kimkyowon/Hat_managing_system/Docs/개발 자료/FW 동작 로직.jpg

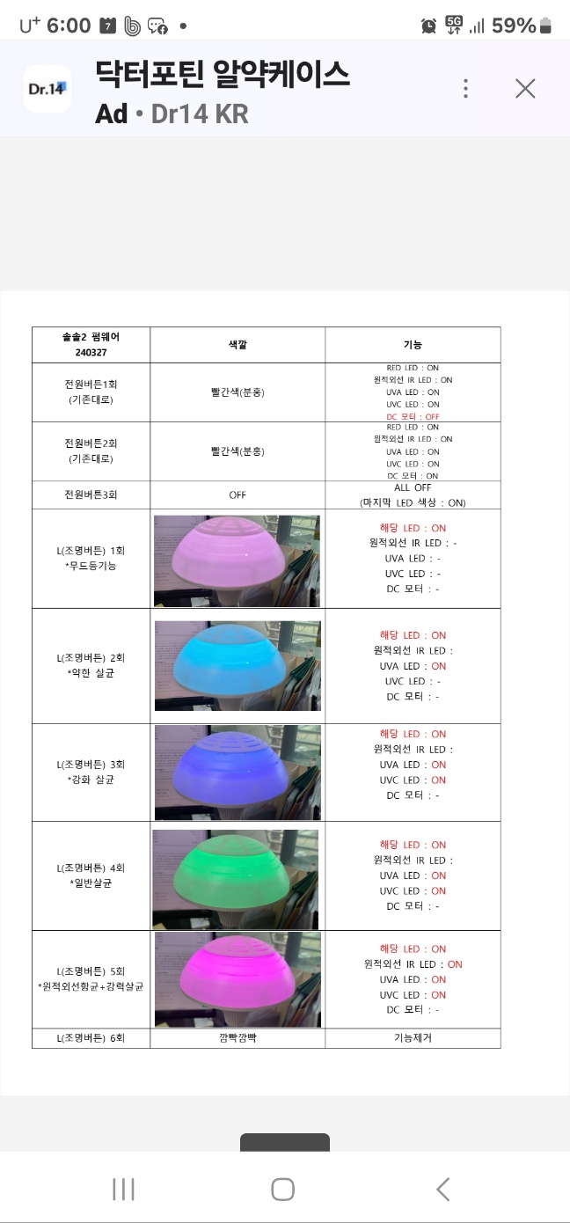
Docs/개발 자료/FW 동작 로직.jpg
