kimkyowon/Hat_managing_system/Docs/개발 자료/회로도 1차/1차회로.pdf

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
## NZR_WIGY_001_01

1 3.0
2024-05-21
C:\Users\thepr\Documents\git\others\NZR_WIGY_001\design\Power.SchDoc

Title

Number:
Date:
File:

Revision:
Sheet of

Author

Security

Doc Size A4 None Hyeonseok Shin

1
2
3
4
5
6
MP | 7

P1

12505WS-07

SW 1

SHDN 4

FB 3

IN 5

GND 2

U2

AP3015KTR-G1

FB1

MH1608-121Y

D1

SS14A

IN 1

EN 3

NC | 4
OUT | 5

GND 2

U1

TLV70233DBVR

L1

10uH

C5
4.7uF 10V

C4
10uF 6.3V

C2
0.1uF 50V

C1
0.1uF 50V

C3
0.1uF 50V

5V

SW2
SW1

5V

C6
1uF 16V

R2
499k 1%

R3
56k 1%

12V

5V

R1

10k 5%

3V3

USBLED

D D

C C

B B

A A

2 3

## NZR_WIGY_001_02

2 3.0

C:\Users\thepr\Documents\git\others\NZR_WIGY_001\design\MCU.SchDoc

Title

Number:

Revision:

Author

Security

Doc Size A4 None Hyeonseok Shin

PA0 7
PA1 8
PA2 9
PA3 10
PA4 11
PA5 12
PA6 13
PA7 14
PA11 16
PA12 17
PA13 18
PA15/PA14-BOOT0 19
PB0/PB1/PB2/PA8 | 15
PB3/PB4/PB5/PB6 | 20
PB7/PB8 | 1
PB9/PC14-OSC32_IN | 2
PC15-OSC32_OUT | 3

NRST 6

VDD/VDDA 4

VSS/VSSA 5

U3

STM32G030F6P6

1
2
3
4
5

P2

### 5 Pin Header

3V3

SWCLK
SWDIO
NRST

C7
0.1uF 50V

LEDD1012_G

UVLED_G

Q1
2N7002K-7

3V3

NRST

USBLED
SW2
SW1
EXTFAN_G

RGBR_G

SWDIO
SWCLK

BOOT 신경쓸것

LED12_G

R4

220R 5%
R6
22k 5%

Q2
R5 | 2N7002K-7

220R 5%
R7
22k 5%

Q3
R10 | 2N7002K-7

220R 5%
R12
22k 5%

Q4
R11 | 2N7002K-7

220R 5%
R13
22k 5%

Q7
R17 | 2N7002K-7

220R 5%
R19
22k 5%

Q8
R20 | 2N7002K-7

220R 5%
R21
22k 5%

Q6
R16 | 2N7002K-7

220R 5%
R18
22k 5%

RGBG_G

RGBB_G

1

### 2 MP

P3

12505WS-02

Q5
R14 | NDS355AN

220R 5%
R15
22k 5%

5V

R9
0.5R 5W

12V

HEATER_G

HEATER_G

EXTFAN_G

LEDD1012_G

RGBR_G

RGBG_G | LED12_G

RGBB_G

UVLED_G

RGB_R

RGB_G

RGB_B

UVLED

LED12

LEDD1012

R8
DNP

D D

C C

B B

A A

3 3

## NZR_WIGY_001_03

3 1.0

C:\Users\thepr\Documents\git\others\NZR_WIGY_001\design\Pheripherals.SchDoc

Title

Number:

Revision:

Author

Security
Doc Size | A4 *
D11 | XL-3528HIR-T202
D8 | CL-SFC281UV-395-B-02
D2 | CL-SFC3535UVC-270

D3
SFC506BRG-01
D12 | XL-3528HIR-T202
D15 | XL-3528HIR-T202
D5 | CL-SFC281UV-395-B-02

R22

121R 1%

R34

21R 1%

R43

68R 1%

R29

21R 1%

R46

68R 1%

R51

68R 1%

R27 | 294R 1%
R23 | 191R 1%
R25 | 191R 1%

5V

D6
SFC506BRG-01
R35 | 294R 1%
R30 | 191R 1%
R32 | 191R 1%

D9
SFC506BRG-01
R41 | 294R 1%
R37 | 191R 1%
R39 | 191R 1%

D4
SFC506BRG-01
R28 | 294R 1%
R24 | 191R 1%
R26 | 191R 1%

D7
SFC506BRG-01
R36 | 294R 1%
R31 | 191R 1%
R33 | 191R 1%

D10
SFC506BRG-01
R42 | 294R 1%
R38 | 191R 1%
R40 | 191R 1%

D13
SFC506BRG-01
R49 | 294R 1%
R44 | 191R 1%
R47 | 191R 1%

D16
SFC506BRG-01
R56 | 294R 1%
R52 | 191R 1%
R54 | 191R 1%

D18
SFC506BRG-01
R62 | 294R 1%
R58 | 191R 1%
R60 | 191R 1%

D14
SFC506BRG-01
R50 | 294R 1%
R45 | 191R 1%
R48 | 191R 1%

D17
SFC506BRG-01
R57 | 294R 1%
R53 | 191R 1%
R55 | 191R 1%

D19
SFC506BRG-01
R63 | 294R 1%
R59 | 191R 1%
R61 | 191R 1%

5V

RGB_R
RGB_G
RGB_B

5V

UVLED

LED12

LEDD1012
