kimkyowon/Hat_managing_system/Docs/개발 자료/회로도 1차/1차회로_usb.pdf

# NZR_WIGYUSB_001

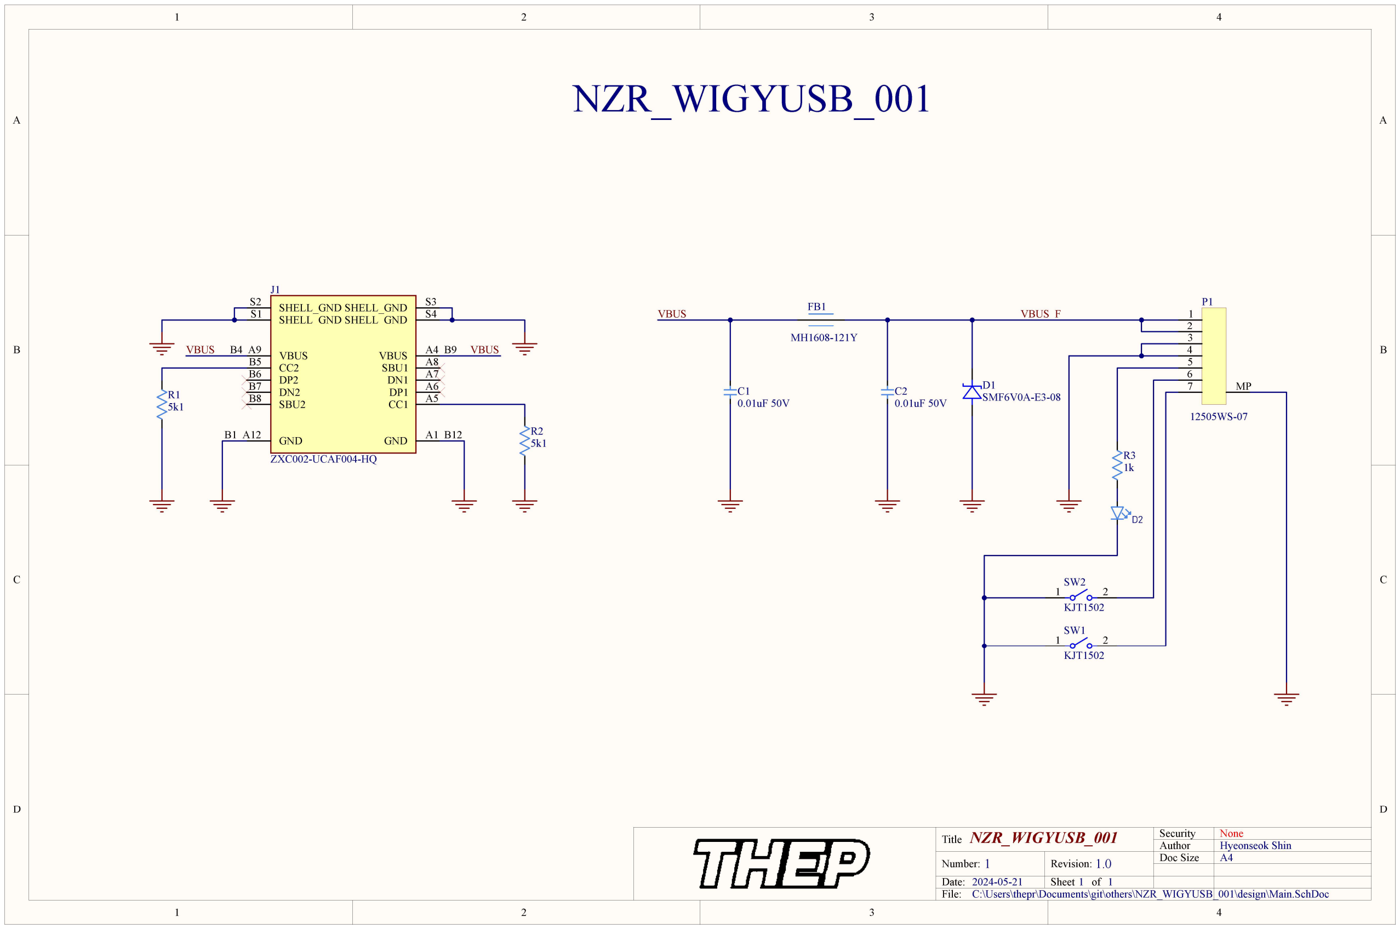
[picture p2: page 1]

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
## NZR_WIGYUSB_001

1 1.0
2024-05-21
C:\Users\thepr\Documents\git\others\NZR_WIGYUSB_001\design\Main.SchDoc

Title

Number:
Date:
File:

Revision:
Sheet of

Author

Security

Doc Size | A4 None Hyeonseok Shin
CC1 | A5 DP1 | A6 DN1 | A7 SBU1 | A8 VBUS | A4_B9 VBUS B4_A9
CC2 B5
DP2 B6
DN2 B7
SBU2 B8
GND | A1_B12 GND B1_A12
SHELL_GND S1 | SHELL_GND S2 | SHELL_GND | S3
| | SHELL_GND | S4

J1

ZXC002-UCAF004-HQ

D2

R2
5k1

D1
SMF6V0A-E3-08 C1
0.01uF 50V

1
2
3
4
5
6

### 7 MP

P1

12505WS-07

FB1

MH1608-121Y

R1
5k1
VBUS | VBUS

VBUS

C2
0.01uF 50V

VBUS_F

1 2

SW2

KJT1502

1 2

SW1

KJT1502

R3
1k
