kimkyowon/Hat_managing_system/Docs/개발 자료/Main_B SCH.png

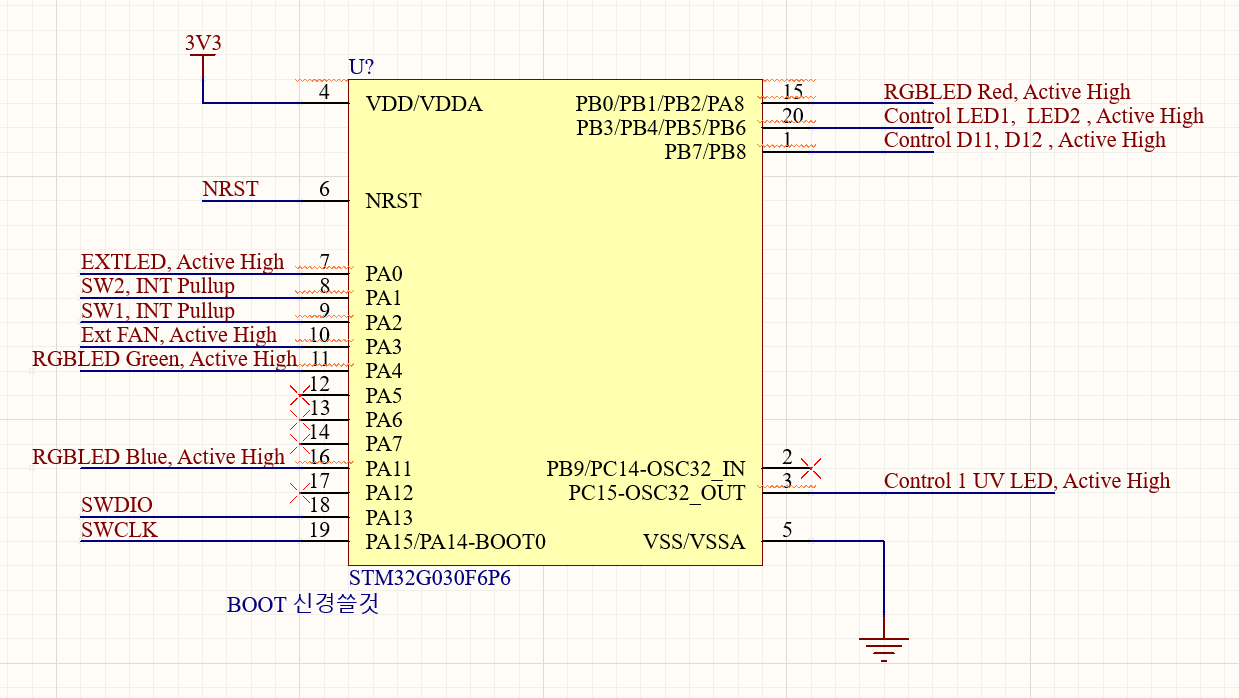
Docs/개발 자료/Main_B SCH.png
