kimkyowon/Hat_managing_system/Docs/견적서/자재_Bomlist/1차 제안서 기반 버전/김교원연구원(3KSET)견적서.xlsx

주식회사 플랜비넷
견 적 서
견적일자 : 2024년 04월 16일
 |  |  |  |  |  |  |  |  |  |  |  | 견적 번호 : P-240416-01
상 호 |  | . |  |  |  |  | 발 주 자 | 등록번호 | 202 - 81 - 66529
담당자 |  | 김교원연구원님 |  |  |  |  |  | 상 호 | 주식회사 플랜비넷 |  |  | 성 명 | 이 진희
Tel |  |  |  |  |  |  |  | 주 소 | 서울시 금천구 디지털로10길 78, 828호(가산테라타워)
Fax |  |  |  |  |  |  |  | 업 태 | 도매 |  |  | 종 목 | 전자부품, 무역
아래와 같이 견적합니다. |  |  |  |  |  |  |  | 전화번호 | 02-6230-5080 |  |  | 팩스 | 02-6230-5081
합 계 금 액 : |  |  | ₩18240530.00 |  |  |  |  | (VAT포함)
NO | Part Number |  |  |  | Maker |  |  | Q'ty | Price |  | Amuont |  |  | Delivery
1 | 12505WS-07 | 12505WS-07 | 12505WS-07 | 12505WS-07 | YEONHO | YEONHO | YEONHO | 3000 | ₩98.0 |  | ₩294000.00
2 | 12505WS-02 | 12505WS-02 | 12505WS-02 | 12505WS-02 | YEONHO | YEONHO | YEONHO | 3000 | ₩65.0 |  | ₩195000.00
3 | WCR 5ohm 5W | WCR 5ohm 5W | WCR 5ohm 5W | WCR 5ohm 5W | 바로전자 | 바로전자 | 바로전자 | 3000 | ₩150.0 |  | ₩450000.00
4 | 2N7002K-7 | 2N7002K-7 | 2N7002K-7 | 2N7002K-7 | DIODES | DIODES | DIODES | 21000 | ₩14.0 |  | ₩294000.00
5 | AP3015KTR-G1 | AP3015KTR-G1 | AP3015KTR-G1 | AP3015KTR-G1 | DIODES | DIODES | DIODES | 3000 | ₩230.0 |  | ₩690000.00
6 | MH1608-121Y | PZ1608U121-2R0TF | PZ1608U121-2R0TF | PZ1608U121-2R0TF | Bourns | SUNLOR | SUNLOR | 4000 | ₩33.0 |  | ₩132000.00 |  |  | 1REEL=4K
7 | NDS355AN | NDS355AN | NDS355AN | NDS355AN | ONSEMI | ONSEMI | ONSEMI | 3000 | ₩210.0 |  | ₩630000.00
8 | SS14A | SS14A | SS14A | SS14A | LSE | LSE | LSE | 5000 | ₩25.0 |  | ₩125000.00 |  |  | 1REEL=5K
9 | TLV70233DBVR | TLV70233DBVR | TLV70233DBVR | TLV70233DBVR | TI | TI | TI | 3000 | ₩65.0 |  | ₩195000.00
10 | EMC4012S-100M | EMC4012S-100M | EMC4012S-100M | EMC4012S-100M | EL3 | EL3 | EL3 | 4500 | ₩190.0 |  | ₩855000.00
11 | STM32G030F6P6 | STM32G030F6P6 | STM32G030F6P6 | STM32G030F6P6 | STM | STM | STM | 3000 | ₩425.0 |  | ₩1275000.00
12 | SFC506BRG-01 | S6-5050RGBTA TUOZHAN | S6-5050RGBTA TUOZHAN | S6-5050RGBTA TUOZHAN | CIELLIGHT | TUOZHAN | TUOZHAN | 27000 | ₩85.0 | ₩309.0 | ₩2295000.00 |  |  | S6-5050RGBTA 대치 핀맵 다름 확인 요청
13 | XL-3528HIR-T202 | XL-3528HIR-T202 | XL-3528HIR-T202 | XL-3528HIR-T202 | XINGLIGHT | TUOZHAN | TUOZHAN | 9000 | ₩90.0 | ₩666.0 | ₩810000.00 |  |  | XL-3528HIR-T202 대치 핀맵 동일
14 | SFC281UV-395-B-02(+) | NTD3528U2 | NTD3528U2 | NTD3528U2 | CIELLIGHT | TUOZHAN | TUOZHAN | 6000 | ₩80.0 | ₩495.0 | ₩480000.00 |  |  | NTD3528U2 핀맵 동일
15 | SFC3535UVC-270(15mW) | G3535N1UVN5U12-275NM | G3535N1UVN5U12-275NM | G3535N1UVN5U12-275NM | CIELLIGHT | TUOZHAN | TUOZHAN | 3000 | ₩1425 | ₩3212 | ₩4275000.00 |  |  | G3535N1UVN5U12-275nm 대치
16 | CRCW1210121RFKEA | CRCW1210121RFKEA | CRCW1210121RFKEA | CRCW1210121RFKEA | VISHAY | VISHAY | VISHAY | 5000 | ₩53.0 |  | ₩265000.00 |  |  | 1reel=5k
17 | WR12X21R0FTL | 21/1%/R3216 | 21/1%/R3216 | 21/1%/R3216 | Walsin | ANY | ANY | 10000 | ₩2.6 |  | ₩26000.00 |  |  | 1reel=5k
18 | WR12X68R0FTL | 68/1%/R3216 | 68/1%/R3216 | 68/1%/R3216 | Walsin | ANY | ANY | 10000 | ₩2.6 |  | ₩26000.00 |  |  | 1reel=5k
19 | WR06X1910FTL | 191/1%/R1608 | 191/1%/R1608 | 191/1%/R1608 | Walsin | ANY | ANY | 55000 | ₩0.9 |  | ₩49500.00 |  |  | 1reel=5k
20 | WR06X2940FTL | 294/1%/R1608 | 294/1%/R1608 | 294/1%/R1608 | Walsin | ANY | ANY | 30000 | ₩0.9 |  | ₩27000.00 |  |  | 1reel=5k
21 | WR04X4993FTL | 499K/1%/R1005 | 499K/1%/R1005 | 499K/1%/R1005 | Walsin | ANY | ANY | 10000 | ₩0.65 |  | ₩6500.00 |  |  | 1reel=10k
22 | WR04X5602FTL | 56k/1%/R1005 | 56k/1%/R1005 | 56k/1%/R1005 | Walsin | ANY | ANY | 10000 | ₩0.65 |  | ₩6500.00 |  |  | 1reel=10k
23 | WR04X103 JTL | 10K/5%/R1005 | 10K/5%/R1005 | 10K/5%/R1005 | Walsin | ANY | ANY | 20000 | ₩0.55 |  | ₩11000.00 |  |  | 1reel=10k
24 | WR04X221 JTL | 220 220/5%/R1005 | 220 220/5%/R1005 | 220 220/5%/R1005 | Walsin | ANY | ANY | 30000 | ₩0.55 |  | ₩16500.00 |  |  | 1reel=10k
25 | WR04X223 JTL | 22k/5%/R1005 | 22k/5%/R1005 | 22k/5%/R1005 | Walsin | ANY | ANY | 30000 | ₩0.55 |  | ₩16500.00 |  |  | 1reel=10k
26 | CL05B105KB5NNNC | 100n/50V/C1005 | 100n/50V/C1005 | 100n/50V/C1005 | samsung | ANY | ANY | 20000 | ₩3.8 |  | ₩76000.00 |  |  | 1REEL=10K
27 | CL10A105KO8NNNC | 1uF/16V/C1608 | 1uF/16V/C1608 | 1uF/16V/C1608 | samsung | ANY | ANY | 4000 | ₩3.0 |  | ₩12000.00 |  |  | 1REEL=4K
28 | CL10A475KP8NNNC | 4.7uF/10V/C1608 | 4.7uF/10V/C1608 | 4.7uF/10V/C1608 | samsung | ANY | ANY | 4000 | ₩3.8 |  | ₩15200.00 |  |  | 1REEL=4K
29 | CL10A106KP8NNNC | 10uF/10V/C1608 | 10uF/10V/C1608 | 10uF/10V/C1608 | samsung | ANY | ANY | 4000 | ₩4.9 |  | ₩19600.00 |  |  | 1REEL=4K
 |  |  |  |  |  |  |  |  |  |  | ₩0.00
30 | ZXC002-UCAF004-HQ | ZXC002-UCAF004-HQ | ZXC002-UCAF004-HQ | ZXC002-UCAF004-HQ |  |  |  | 3000 | ₩500.0 |  | ₩1500000.00 |  |  | 1일
31 | MH1608-121Y | PZ1608U121-2R0TF | PZ1608U121-2R0TF | PZ1608U121-2R0TF | Bourns | SUNLOR | SUNLOR | 4000 | ₩33.0 |  | ₩132000.00 |  |  | 1REEL=4K
32 | KJT 1502 250g | KJT 1502 250g | KJT 1502 250g | KJT 1502 250g | KJT | KJT | KJT | 6000 | ₩85 |  | ₩510000.00 |  |  | 1일
33 | NCD0603B1 | NTD3528U2 | NTD3528U2 | NTD3528U2 | NationStar | TUOZHAN | TUOZHAN | 4000 | ₩13.0 | ₩495.0 | ₩52000.00 |  |  | NTD3528U2 핀맵 동일
34 | 12505WR-07 | 12505WR-07 | 12505WR-07 | 12505WR-07 | YEONHO | YEONHO | YEONHO | 3000 | ₩150.0 |  | ₩450000.00
35 | SMF6V0A-E3-08 | SMF6V0A-E3-08 | SMF6V0A-E3-08 | SMF6V0A-E3-08 | Vishay | Vishay | Vishay | 3000 | ₩107.0 |  | ₩321000.00
36 | CL05B105KB5NNNC | 100n/50V/C1005 | 100n/50V/C1005 | 100n/50V/C1005 | ANY | ANY | ANY | 10000 | ₩3.8 |  | ₩38000.00 |  |  | 1REEL=10K
37 | WR04X102 JTL | 1K/5%/R1005 | 1K/5%/R1005 | 1K/5%/R1005 | ANY | ANY | ANY | 10000 | ₩0.55 |  | ₩5500.00 |  |  | 1REEL=10K
38 | WR04X512 JTL | 5.1K/5%/R1005 | 5.1K/5%/R1005 | 5.1K/5%/R1005 | ANY | ANY | ANY | 10000 | ₩0.55 |  | ₩5500.00 |  |  | 1REEL=10K
39 |  |  |  |  |  |  |  |  |  |  | ₩0.00
40 |  |  |  |  |  |  |  |  |  |  | ₩0.00
 |  |  |  |  |  |  |  |  |  |  | ₩0.00
합 계 |  |  |  |  |  |  |  |  |  |  | ₩16582300
납기일자 |  |  |  |  |  |  |  | 납품장소
유효일자 |  |  |  |  |  |  |  | 결제조건
비 고 |  | 담당자 : 이승진과장 010-6359-0223
