kimkyowon/Hat_managing_system/Docs/견적서/자재_Bomlist/1차 제안서 기반 버전/김교원연구원(SAMPLE)견적서-0416.xlsx

주식회사 플랜비넷
견 적 서
견적일자 : 2024년 04월 16일
 |  |  |  |  |  |  |  |  |  |  |  | 견적 번호 : P-240416-01
상 호 |  | . |  |  |  |  | 발 주 자 | 등록번호 | 202 - 81 - 66529
담당자 |  | 김교원연구원님 |  |  |  |  |  | 상 호 | 주식회사 플랜비넷 |  |  | 성 명 | 이 진희
Tel |  |  |  |  |  |  |  | 주 소 | 서울시 금천구 디지털로10길 78, 828호(가산테라타워)
Fax |  |  |  |  |  |  |  | 업 태 | 도매 |  |  | 종 목 | 전자부품, 무역
아래와 같이 견적합니다. |  |  |  |  |  |  |  | 전화번호 | 02-6230-5080 |  |  | 팩스 | 02-6230-5081
합 계 금 액 : |  |  | ₩53306.00 |  |  |  |  | (VAT포함)
NO | Part Number |  |  |  | Maker |  |  | Q'ty | Price |  | Amuont |  |  | Delivery
1 | 12505WS-07 | 12505WS-07 | 12505WS-07 | 12505WS-07 | YEONHO | YEONHO | YEONHO | 1 | ₩0.0 | ₩0.0 | ₩0.00 |  |  | SAMPLE
2 | 12505WS-02 | 12505WS-02 | 12505WS-02 | 12505WS-02 | YEONHO | YEONHO | YEONHO | 1 | ₩0.0 | ₩0.0 | ₩0.00 |  |  | SAMPLE
3 | WCR 5ohm 5W | WCR 5ohm 5W | WCR 5ohm 5W | WCR 5ohm 5W | 바로전자 | 바로전자 | 바로전자 | 10 | ₩180.0 | ₩180.0 | ₩1800.00
4 | 2N7002K-7 | 2N7002K-7 | 2N7002K-7 | 2N7002K-7 | DIODES | DIODES | DIODES | 7 | ₩252.0 | ₩252.0 | ₩1764.00
5 | AP3015KTR-G1 | AP3015KTR-G1 | AP3015KTR-G1 | AP3015KTR-G1 | DIODES | DIODES | DIODES | 1 | ₩1189.0 | ₩1189.0 | ₩1189.00
6 | MH1608-121Y | PZ1608U121-2R0TF | PZ1608U121-2R0TF | PZ1608U121-2R0TF | Bourns | SUNLOR | SUNLOR | 5 | ₩127 | ₩0 | ₩635.00 |  |  | SAMPLE
7 | NDS355AN | NDS355AN | NDS355AN | NDS355AN | ONSEMI | ONSEMI | ONSEMI | 1 | ₩907.0 | ₩907.0 | ₩907.00
8 | SS14A | SS14A | SS14A | SS14A | LSE | LSE | LSE | 10 | ₩35.0 | ₩35.0 | ₩350.00
9 | TLV70233DBVR | TLV70233DBVR | TLV70233DBVR | TLV70233DBVR | TI | TI | TI | 1 | ₩740.0 | ₩740.0 | ₩740.00
10 | EMC4012S-100M | EMC4012S-100M | EMC4012S-100M | EMC4012S-100M | EL3 | EL3 | EL3 | 5 | ₩0.0 | ₩0.0 | ₩0.00 |  |  | SAMPLE
11 | STM32G030F6P6 | STM32G030F6P6 | STM32G030F6P6 | STM32G030F6P6 | STM | STM | STM | 1 | ₩2486.0 | ₩2486.0 | ₩2486.00
12 | SFC506BRG-01 | S6-5050RGBTA TUOZHAN | S6-5050RGBTA TUOZHAN | S6-5050RGBTA TUOZHAN | CIELLIGHT | TUOZHAN | TUOZHAN | 20 | ₩100.0 | ₩309.0 | ₩2000.00 |  |  | S6-5050RGBTA 대치 핀맵 다름 확인 요청
13 | XL-3528HIR-T202 | XL-3528HIR-T202 | XL-3528HIR-T202 | XL-3528HIR-T202 | XINGLIGHT | TUOZHAN | TUOZHAN | 10 | ₩210.0 | ₩666.0 | ₩2100.00 |  |  | 9일
14 | SFC281UV-395-B-02(+) | NTD3528U2 | NTD3528U2 | NTD3528U2 | CIELLIGHT | TUOZHAN | TUOZHAN | 10 | ₩100.0 | ₩495.0 | ₩1000.00 |  |  | NTD3528U2 핀맵 동일
15 | SFC3535UVC-270(15mW) | G3535N1UVN5U12-275NM | G3535N1UVN5U12-275NM | G3535N1UVN5U12-275NM | CIELLIGHT | TUOZHAN | TUOZHAN | 10 | ₩2000 | ₩3212 | ₩20000.00 |  |  | G3535N1UVN5U12-275nm 대치 납기 3-4주
16 | CRCW1210121RFKEA | CRCW1210121RFKEA | CRCW1210121RFKEA | CRCW1210121RFKEA | VISHAY | VISHAY | VISHAY | 2 | ₩407.0 | ₩407.0 | ₩814.00
17 | 21/1%/R3216 | 21/1%/R3216 | 21/1%/R3216 | 21/1%/R3216 | ANY | ANY | ANY | 100 | ₩7.0 | ₩7.0 | ₩700.00
18 | 68/1%/R3216 | 68/1%/R3216 | 68/1%/R3216 | 68/1%/R3216 | ANY | ANY | ANY | 100 | ₩7.0 | ₩7.0 | ₩700.00
19 | 191/1%/R1608 | 191/1%/R1608 | 191/1%/R1608 | 191/1%/R1608 | ANY | ANY | ANY | 100 | ₩6.0 | ₩6.0 | ₩600.00
20 | 294/1%/R1608 | 294/1%/R1608 | 294/1%/R1608 | 294/1%/R1608 | ANY | ANY | ANY | 100 | ₩6.0 | ₩6.0 | ₩600.00
21 | 499K/1%/R1005 | 499K/1%/R1005 | 499K/1%/R1005 | 499K/1%/R1005 | ANY | ANY | ANY | 100 | ₩6.0 | ₩6.0 | ₩600.00
22 | 56k/1%/R1005 | 56k/1%/R1005 | 56k/1%/R1005 | 56k/1%/R1005 | ANY | ANY | ANY | 100 | ₩6.0 | ₩6.0 | ₩600.00
23 | 10K/5%/R1005 | 10K/5%/R1005 | 10K/5%/R1005 | 10K/5%/R1005 | ANY | ANY | ANY | 100 | ₩6.0 | ₩6.0 | ₩600.00
24 | 220 220/5%/R1005 | 220 220/5%/R1005 | 220 220/5%/R1005 | 220 220/5%/R1005 | ANY | ANY | ANY | 100 | ₩6 | ₩6 | ₩600.00
25 | 22k/5%/R1005 | 22k/5%/R1005 | 22k/5%/R1005 | 22k/5%/R1005 | ANY | ANY | ANY | 100 | ₩6.0 | ₩6.0 | ₩600.00
26 | 100n/50V/C1005 | 100n/50V/C1005 | 100n/50V/C1005 | 100n/50V/C1005 | ANY | ANY | ANY | 50 | ₩13.0 | ₩13.0 | ₩650.00
27 | 1uF/16V/C1608 | 1uF/16V/C1608 | 1uF/16V/C1608 | 1uF/16V/C1608 | ANY | ANY | ANY | 50 | ₩13.0 | ₩13.0 | ₩650.00
28 | 4.7uF/10V/C1608 | 4.7uF/10V/C1608 | 4.7uF/10V/C1608 | 4.7uF/10V/C1608 | ANY | ANY | ANY | 50 | ₩18.0 | ₩18.0 | ₩900.00
29 | 10uF/10V/C1608 | 10uF/10V/C1608 | 10uF/10V/C1608 | 10uF/10V/C1608 | ANY | ANY | ANY | 50 | ₩25.0 | ₩25.0 | ₩1250.00
 |  |  |  |  |  |  |  |  |  |  | ₩0.00
30 | ZXC002-UCAF004-HQ | ZXC002-UCAF004-HQ | ZXC002-UCAF004-HQ | ZXC002-UCAF004-HQ |  |  |  | 1 | ₩0.0 | ₩0.0 | ₩0.00 |  |  | SAMPLE
31 | MH1608-121Y | PZ1608U121-2R0TF | PZ1608U121-2R0TF | PZ1608U121-2R0TF | Bourns | SUNLOR | SUNLOR | 5 | ₩127.0 | ₩0.0 | ₩635.00 |  |  | SAMPLE
32 | KJT 1502 250g | KJT 1502 250g | KJT 1502 250g | KJT 1502 250g | KJT | KJT | KJT | 2 | ₩0 | ₩0 | ₩0.00 |  |  | SAMPLE
33 | NCD0603B1 | NTD3528U2 | NTD3528U2 | NTD3528U2 | NationStar | TUOZHAN | TUOZHAN | 10 | ₩40.0 |  | ₩400.00 |  |  | 9일
34 | 12505WR-07 | 12505WR-07 | 12505WR-07 | 12505WR-07 | YEONHO | YEONHO | YEONHO | 1 | ₩0.0 | ₩0.0 | ₩0.00 |  |  | SAMPLE
35 | SMF6V0A-E3-08 | SMF6V0A-E3-08 | SMF6V0A-E3-08 | SMF6V0A-E3-08 | Vishay | Vishay | Vishay | 1 | ₩740.0 | ₩740.0 | ₩740.00
36 | 100n/50V/C1005 | 100n/50V/C1005 | 100n/50V/C1005 | 100n/50V/C1005 | ANY | ANY | ANY | 50 | ₩13.0 | ₩13.0 | ₩650.00
37 | 1K/5%/R1005 | 1K/5%/R1005 | 1K/5%/R1005 | 1K/5%/R1005 | ANY | ANY | ANY | 100 | ₩6.0 | ₩6.0 | ₩600.00
38 | 5.1K/5%/R1005 | 5.1K/5%/R1005 | 5.1K/5%/R1005 | 5.1K/5%/R1005 | ANY | ANY | ANY | 100 | ₩6.0 | ₩6.0 | ₩600.00
39 |  |  |  |  |  |  |  |  |  |  | ₩0.00
40 |  |  |  |  |  |  |  |  |  |  | ₩0.00
 |  |  |  |  |  |  |  |  |  |  | ₩0.00
합 계 |  |  |  |  |  |  |  |  |  |  | ₩48460
납기일자 |  |  |  |  |  |  |  | 납품장소
유효일자 |  |  |  |  |  |  |  | 결제조건
비 고 |  | 담당자 : 이승진과장 010-6359-0223
