kimkyowon/Hat_managing_system/Docs/견적서/SMT/하프하프-SMT.xlsx

주식회사 플랜비넷
견 적 서
견적일자 : 2024년 04월 19일
 |  |  |  |  |  |  |  |  | 견적 번호 : P-240419-01
상 호 |  | 하프하프 |  |  | 발 주 자 | 등록번호 | 202 - 81 - 66529
담당자 |  | 신현석님 |  |  |  | 상 호 | 주식회사 플랜비넷 |  | 성 명 | 이 진희
Tel |  |  |  |  |  | 주 소 | 서울시 금천구 디지털로10길 78, 828호(가산테라타워)
Fax |  |  |  |  |  | 업 태 | 도매 |  | 종 목 | 전자부품, 무역
아래와 같이 견적합니다. |  |  |  |  |  | 전화번호 | 02-6230-5080 |  | 팩스 | 02-6230-5081
합 계 금 액 : |  |  | ₩7869400.00 |  |  | (VAT포함)
NO | Part Number |  |  | Maker |  | Q'ty | Price | Amuont |  |  | Delivery
1 | WIGY-DAUGHTER |  |  | SMT |  | 3000 | ₩318.0 | ₩954000.00 |  |  | PCB ARRAY:5*4=20EA/1KIT 기준 단가임입니다.
2 | METAL MASK |  |  |  |  | 2 | ₩110000.0 | ₩220000.00
3 |  |  |  |  |  |  |  | ₩0.00
4 | 2.WIGY-MAIN |  |  | SMT |  | 3000 | ₩880.0 | ₩2640000.00 |  |  | PCB ARRAY:2*2=4EA/1KIT 기준 단가임입니다.
5 | METAL MASK |  |  |  |  | 2 | ₩110000.0 | ₩220000.00
6 |  |  |  |  |  |  |  | ₩0.00
7 | NZR_WIGY_00 Main |  |  | FR-4 / 1.6T / Hoz / 2층 / 흰색psr / 검정 silk / OSP / 65*65 |  | 3000 | ₩790.0 | ₩2370000.00 |  |  | 개별라우터
8 | NZR_WIGYUSB_001 |  |  | FR-4 / 1.6T / Hoz / 2층 / 흰색psr / 검정 silk / OSP / 35*20 / KIT SIZE 94*108(2*5) |  | 3000 | ₩250.0 | ₩750000.00 |  |  | 중간가이드바 삽입
9 |  |  |  |  |  |  |  | ₩0.00
10 |  |  |  |  |  |  |  | ₩0.00
11 |  |  |  |  |  |  |  | ₩0.00
 |  |  |  |  |  |  |  | ₩0.00
합 계 |  |  |  |  |  |  |  | ₩7154000
납기일자 |  |  |  |  |  | 납품장소
유효일자 |  |  |  |  |  | 결제조건
비 고 |  | 담당자 : 이승진과장 010-6359-0223
