kimkyowon/Hat_managing_system/Src/Core/Inc/main.h

#define LEDD1012_G_Pin GPIO_PIN_7
#define LEDD1012_G_GPIO_Port GPIOB
#define Heater_G_Pin GPIO_PIN_14
#define Heater_G_GPIO_Port GPIOC
#define UVLED_G_Pin GPIO_PIN_15
#define UVLED_G_GPIO_Port GPIOC
#define USBLED_Pin GPIO_PIN_0
#define USBLED_GPIO_Port GPIOA
#define SW2_Pin GPIO_PIN_1
#define SW2_GPIO_Port GPIOA
#define SW2_EXTI_IRQn EXTI0_1_IRQn
#define SW1_Pin GPIO_PIN_2
#define SW1_GPIO_Port GPIOA
#define SW1_EXTI_IRQn EXTI2_3_IRQn
#define EXTFAN_G_Pin GPIO_PIN_3
#define EXTFAN_G_GPIO_Port GPIOA
#define RGB_Blue_G_Pin GPIO_PIN_4
#define RGB_Blue_G_GPIO_Port GPIOA
#define RGB_Green_G_Pin GPIO_PIN_0
#define RGB_Green_G_GPIO_Port GPIOB
#define RGB_Red_G_Pin GPIO_PIN_11
#define RGB_Red_G_GPIO_Port GPIOA
#define LED12_G_Pin GPIO_PIN_3
#define LED12_G_GPIO_Port GPIOB
