kimkyowon/Hat_managing_system/(commit log)

2024-06-01 초기 개발환경 및 프로젝트 커밋
    [LED Spec 비교.xlsx, SAMPLE 견적서 (제품 1개 기준).xlsx, 김교원연구원(3KSET)견적서.xlsx, 김교원연구원(SAMPLE)견적서-0416.xlsx, 업무 정리 및 기록.xlsx, 하프하프-SMT.xlsx]
2024-06-04 핀 세팅 재설정
2024-06-05 임시 커밋(핀 매핑 완료)
2024-06-05 각종 기능별 함수 틀 제작
2024-06-06 mode 별 동작 정의
2024-06-10 샘플 수령 전, 최종버전 샘플 수령 후 장입하여 기존 제품 VS 신규 제품 테스트 진행 필요합니다
2024-06-12 기능 변경 -> System 활성화 시, L sw 비활성화 및 초기화
    추가
    -> Hex,bin 파일 생성
2024-06-12 Configuratoin RGB Pin 세팅 원복
2024-06-18 chore: blink 기능 제거 => L mode 마지막 blink 기능 제거 (원본제품대로 바로 꺼지도록)
    feat : Heater 기능 추가
    => sysmode 2에서 켜지고 3에서 꺼짐
2024-06-18 build : FW Uploader 추가 => FW 업로더 추가, Origin.hex는 최초 버전
2024-06-23 - Added Switch, chore
2024-06-23 - Repair LED Color, TESTED, Release
